StetelThings/iotex-devboard/schematic/IoTeX-Devboard.pdf

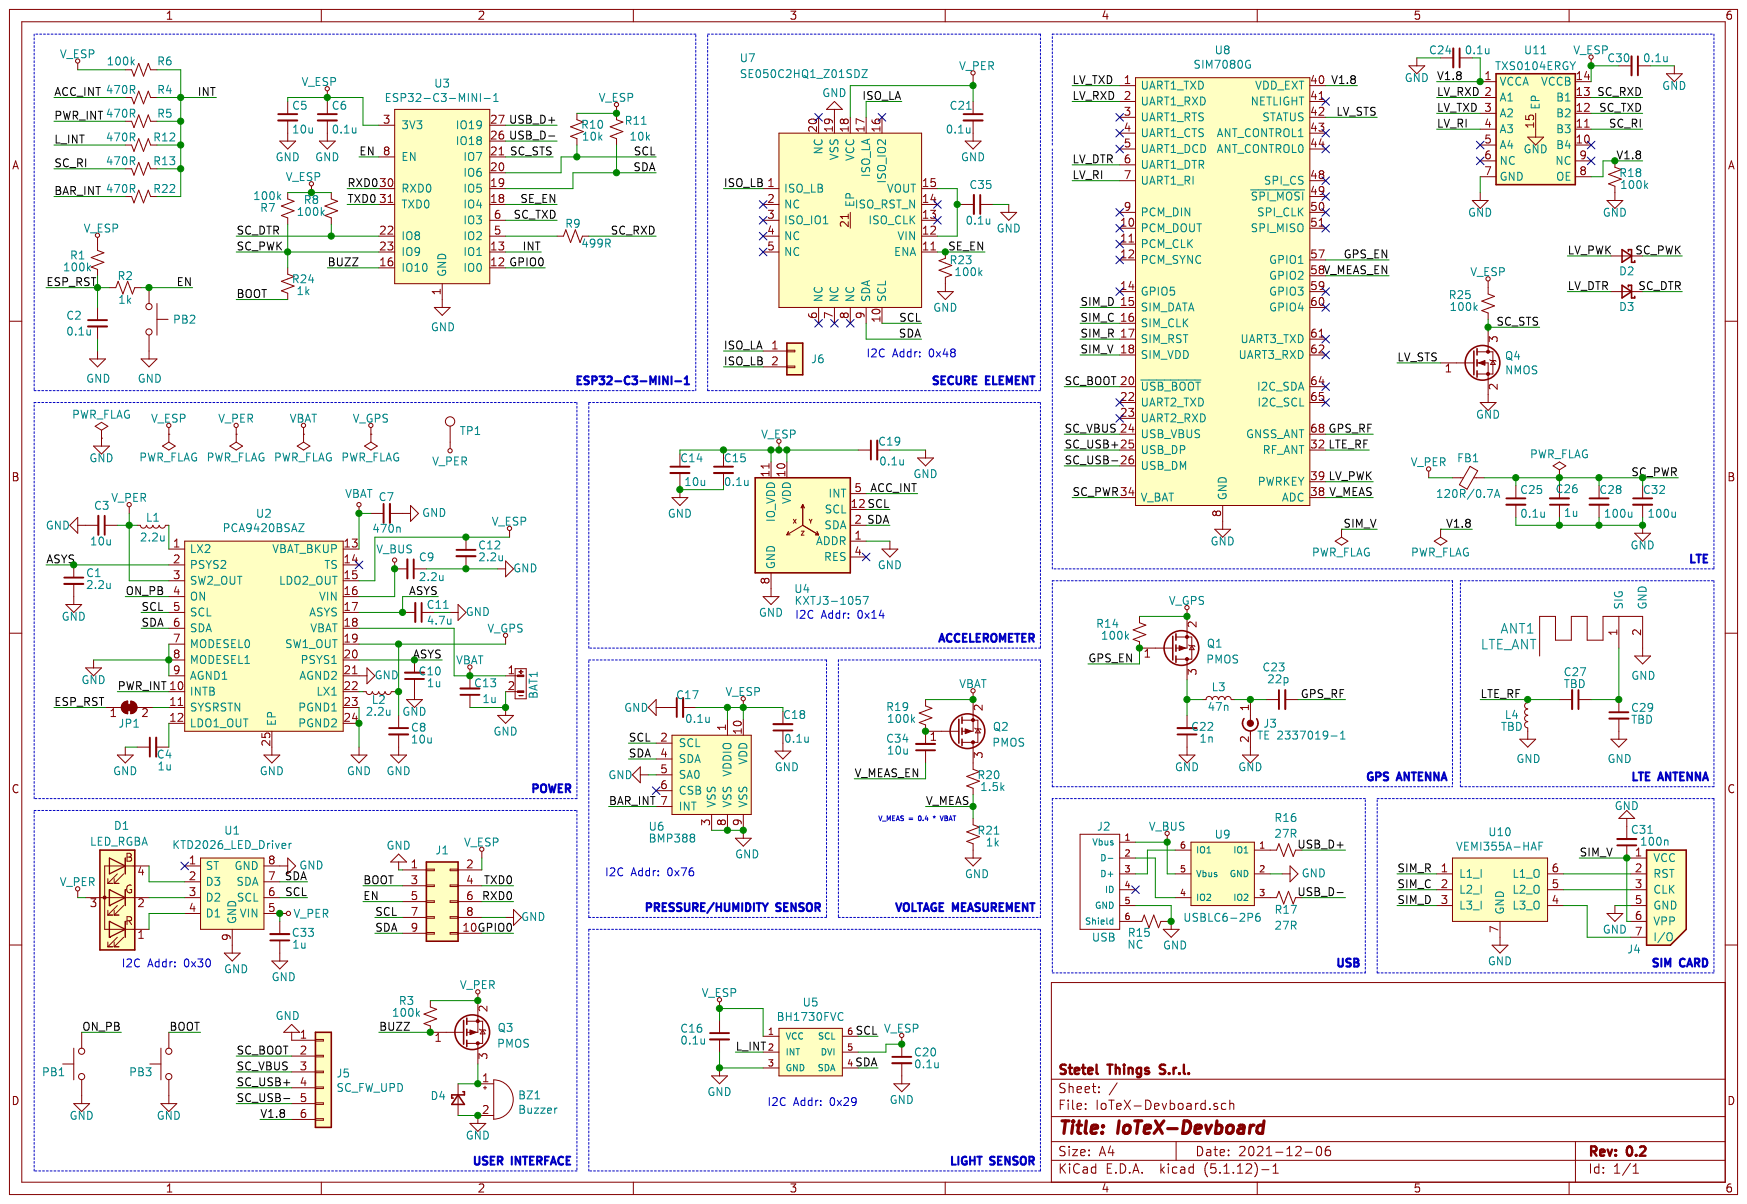
[picture p7: page 1]
