StetelThings/iotex-devboard/schematic/KiCad/IoTeX-Devboard.sch

## KiCad design schematic/KiCad/IoTeX-Devboard.sch (2022-07-04)

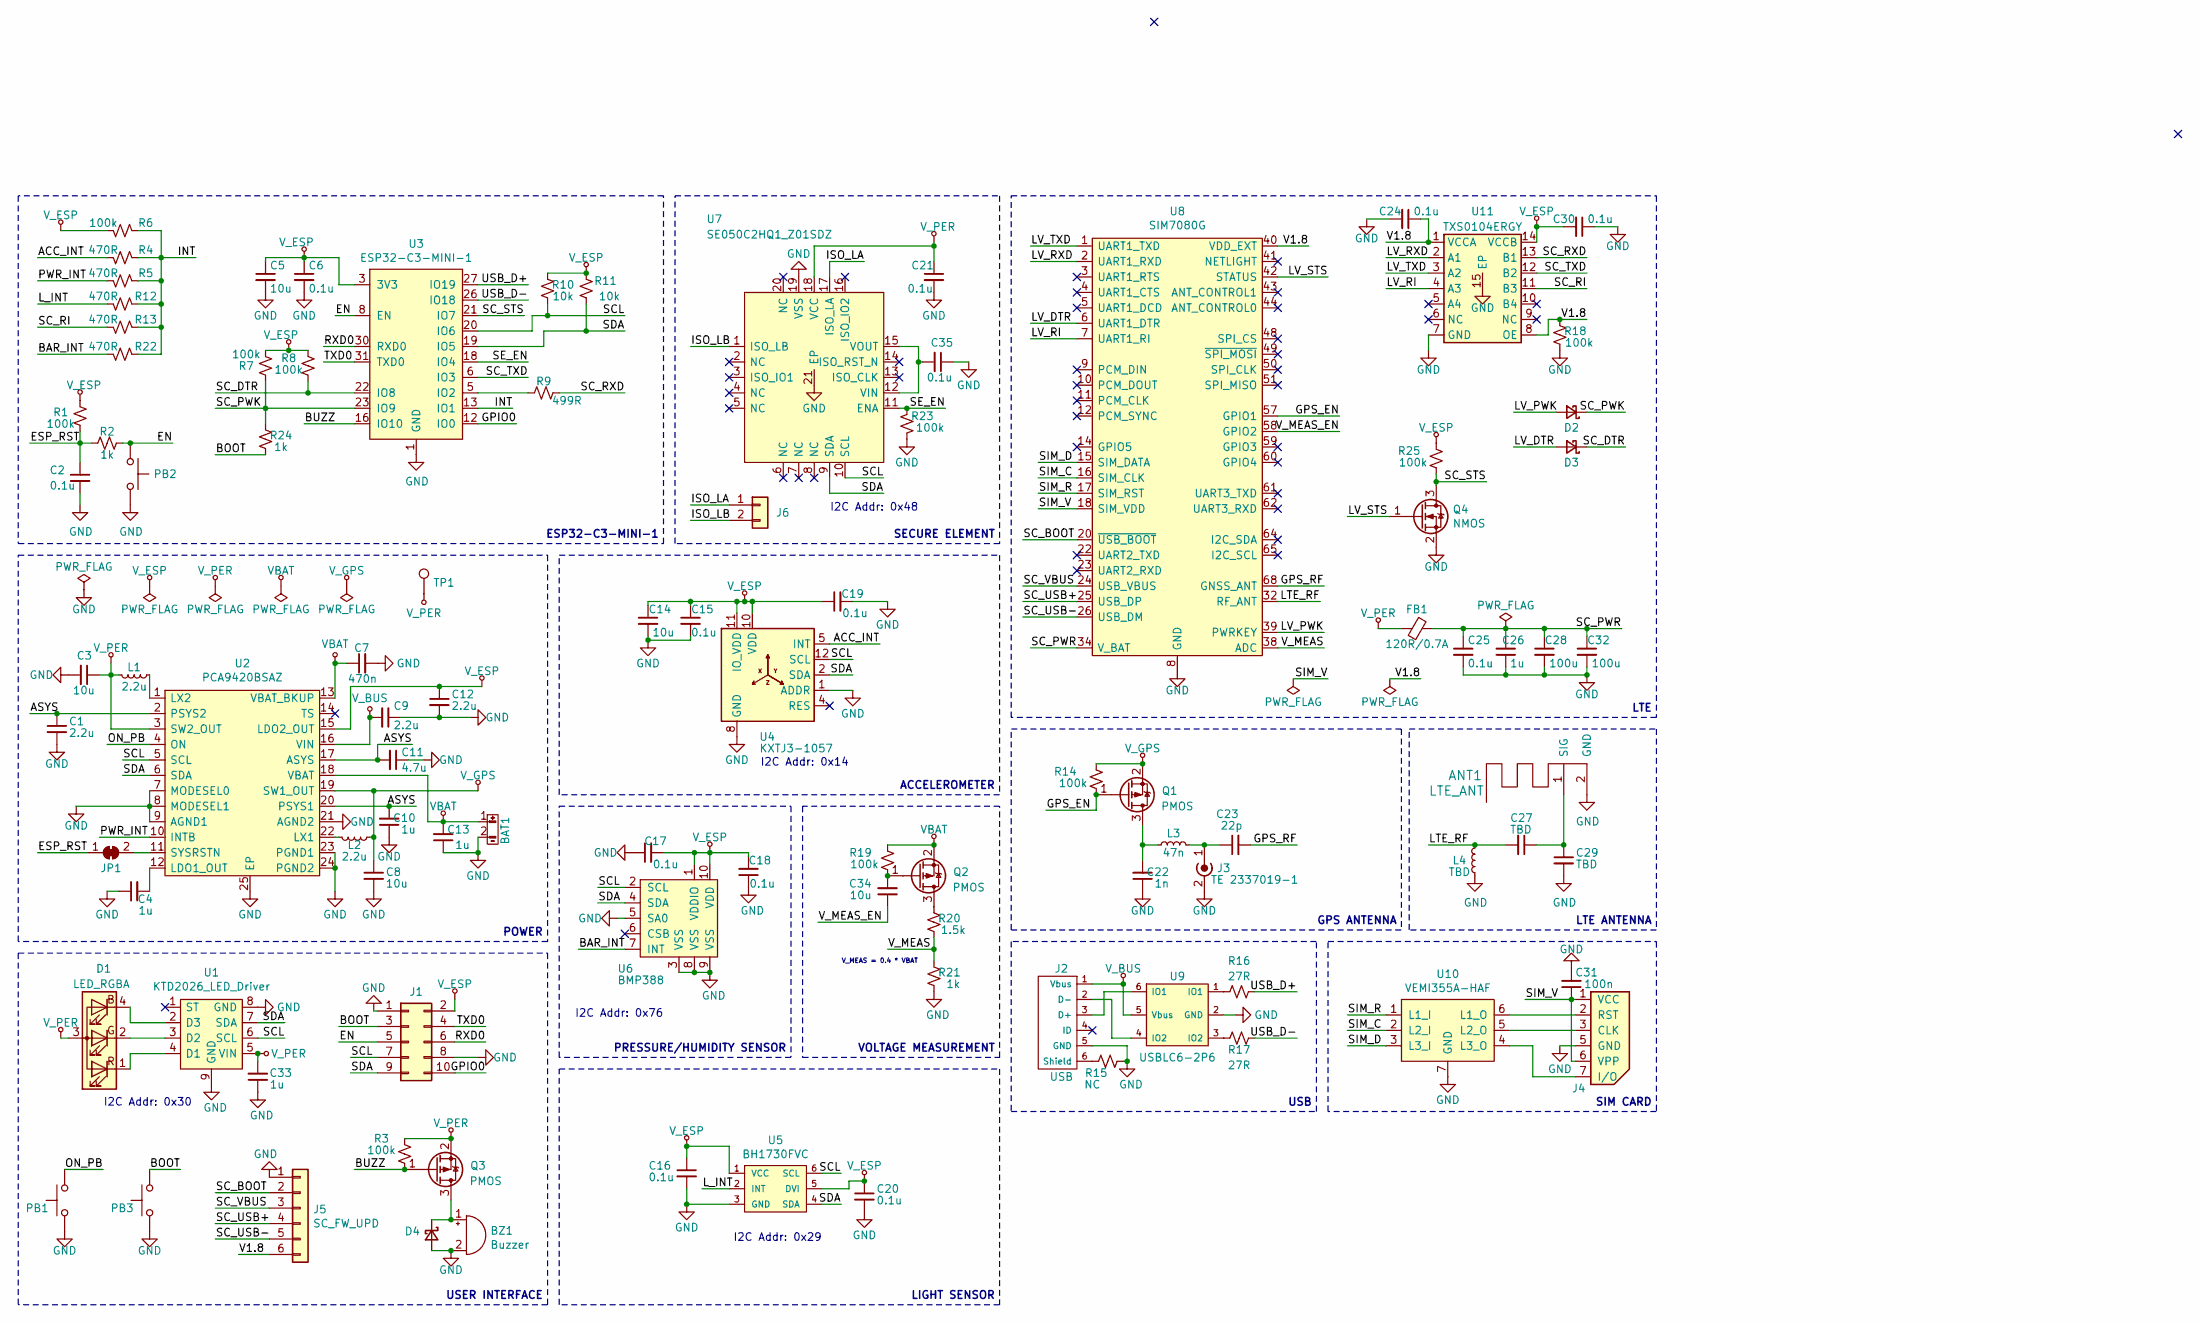
[picture p8: schematic IoTeX-Devboard.sch]

Parts:
ANT1: LTE_ANT; LTE-NB_ANTENNA
BAT1: Battery_Connector; Battery_PADS
BZ1: Buzzer; FUET-4020_BUZZER
C1, C9, C12: 2.2u; C_0402_1005Metric
C2, C6, C15, C16, C17, C18, C19, C20, C21, C24, C25, C30, C35: 0.1u; C_0402_1005Metric
C3, C5, C8, C14, C34: 10u; C_0402_1005Metric
C4, C10, C13, C26, C33: 1u; C_0402_1005Metric
C7: 470n; C_0402_1005Metric
C11: 4.7u; C_0402_1005Metric
C22: 1n; C_0402_1005Metric
C23: 22p; C_0402_1005Metric
C27, C29: TBD; C_0402_1005Metric
C28, C32: 100u; C_1206_3216Metric
C31: 100n; C_0402_1005Metric
D1: LED_RGBA; LED_RGB_IN-S85TATRGB
D2, D3, D4: D_Schottky_Small; D_0603_1608Metric
FB1: 120R/0.7A; L_0603_1608Metric
J1: Conn_02x05_Odd_Even; Wurth_Debug_490107670612_connector_10pins
J2: USB; USB-microB_U254-051T-4BH83-F1S
J3: TE 2337019-1; U.FL_Hirose_U.FL-R-SMT-1_Vertical
J4: SIM_Card_small; XUNPU-SMN-305_C266890_nanoSIM_Holder
J5: SC_FW_UPD; PinHeader_1x06_P1.00mm_Vertical
J6: Conn_01x02; PinHeader_1x02_P1.27mm_Vertical
JP1: SolderJumper_2_Bridged; SolderJumper-2_P1.3mm_Bridged_RoundedPad1.0x1.5mm
L1, L2: 2.2u; L_0805_2012Metric
L3: 47n; L_0402_1005Metric
L4: TBD; L_0402_1005Metric
PB1, PB3: K2-1107UT-A45W-06; SW_SPST_PTS815
PB2: KXT331LHS; SW_SPST_CK_KXT3
Q1, Q2, Q3: PMOS; DFN1006-3
Q4: NMOS
R1, R3, R6, R7, R8, R14, R18, R19, R23, R25: 100k; R_0402_1005Metric
R2, R21, R24: 1k; R_0402_1005Metric
R4, R5, R12, R13, R22: 470R; R_0402_1005Metric
R9: 499R; R_0402_1005Metric
R10, R11: 10k; R_0402_1005Metric
R15: NC; R_0402_1005Metric
R16, R17: 27R; R_0402_1005Metric
R20: 1.5k; R_0402_1005Metric
TP1: TestPoint; TestPoint_Pad_D1.0mm
U1: KTD2026_LED_Driver; SON40P150X150X60-9N-D; Manufacturer_Part_Number KTD2026
U2: PCA9420BSAZ; Manufacturer_Part_Number PCA9420BSAZ; Mouser Part Number 771-PCA9420BSAZ
U3: ESP32-C3-MINI-1
U4: KXTJ3-1057; Kionix_LGA-12_2x2mm_P0.5mm_LayoutBorder2x4y
U5: BH1730FVC; ROHM_BH1730FVC-TR
U6: BMP388
U7: SE050C2HQ1_Z01SDZ; QFN-20-1EP_3x3mm_P0.4mm_EP1.65x1.65mm; Manufacturer_Part_Number SE050C2HQ1/Z01SDZ; Mouser Part Number 771-SE050C2HQ1Z01SDZ
U8: SIM7080G; Manufacturer_Part_Number SIM7080G
U9: USBLC6-2P6
U10: VEMI355A-HAF
U11: TXS0104ERGY; RGY_S-PVQFN-N14_

Connections:
ACC_INT: R4.1, U4.5 (INT)
ASYS: C1.1, C10.2, C11.2, U2.2 (PSYS2), U2.17 (ASYS), U2.20 (PSYS1)
BAR_INT: R22.1, U6.7 (INT)
BOOT: J1.3, PB3.1, R24.1
BUZZ: Q3.1 (G), R3.2, U3.16 (IO10)
EN: J1.5, PB2.1, R2.1, U3.8 (EN)
ESP_RST: C2.1, JP1.1 (A), R1.1, R2.2
GND: ANT1.2 (GND), BAT1.2, BZ1.2 (+), C1.2, C2.2, C3.2, C4.1, C5.2, C6.2, C7.2, C8.2, C9.1, C10.1, C11.1, C12.2, C13.1, C14.2, C15.2, C16.2, C17.1, C18.1, C19.2, C20.2, C21.2, C22.1, C24.2, C25.2, C26.1, C28.2, C29.2, C30.1, C31.2, C32.2, C33.1, C35.1, D4.2 (A), J1.1, J1.8, J2.5 (GND), J3.2 (Ext), J4.5 (GND), J5.1, L4.1, PB1.2, PB2.2, PB3.2, Q4.2 (S), R15.2, R18.2, R21.2, R23.2, U1.8 (GND), U1.9 (GND), U2.7 (MODESEL0), U2.8 (MODESEL1), U2.9 (AGND1), U2.21 (AGND2), U2.23 (PGND1), U2.24 (PGND2), U2.25 (EP), U3.1 (GND), U3.2 (GND), U3.11 (GND), U3.14 (GND), U3.36 (GND), U3.37 (GND), U3.38 (GND), U3.39 (GND), U3.40 (GND), U3.41 (GND), U3.42 (GND), U3.43 (GND), U3.44 (GND), U3.45 (GND), U3.46 (GND), U3.47 (GND), U3.48 (GND), U3.49 (GND), U3.50 (GND), U3.51 (GND), U3.52 (GND), U3.53 (GND), U4.1 (ADDR), U4.6 (GND), U4.8 (GND), U4.9 (GND), U5.3 (GND), U6.3 (VSS), U6.5 (SA0), U6.8 (VSS), U6.9 (VSS), U7.19 (VSS), U7.21 (EP), U8.8 (GND), U8.13 (GND), U8.19 (GND), U8.21 (GND), U8.27 (GND), U8.30 (GND), U8.31 (GND), U8.33 (GND), U8.36 (GND), U8.37 (GND), U8.45 (GND), U8.63 (GND), U8.66 (GND), U8.67 (GND), U8.69 (GND), U8.70 (GND), U8.71 (GND), U8.72 (GND), U8.73 (GND), U8.74 (GND), U8.75 (GND), U8.76 (GND), U8.77 (GND), U9.2 (GND), U10.7 (GND), U11.7 (GND), U11.15 (EP)
GPIO0: J1.10, U3.12 (IO0)
GPS_EN: Q1.1 (G), R14.1, U8.57 (GPIO1)
GPS_RF: C23.2, U8.68 (GNSS_ANT)
INT: R4.2, R5.2, R6.1, R12.2, R13.2, R22.2, U3.13 (IO1)
ISO_LA: J6.1, U7.17 (ISO_LA)
ISO_LB: J6.2, U7.1 (ISO_LB)
LTE_RF: C27.2, L4.2, U8.32 (RF_ANT)
LV_DTR: D3.2 (A), U8.6 (UART1_DTR)
LV_PWK: D2.2 (A), U8.39 (PWRKEY)
LV_RI: U8.7 (UART1_RI), U11.4 (A3)
LV_RXD: U8.2 (UART1_RXD), U11.2 (A1)
LV_STS: Q4.1 (G), U8.42 (STATUS)
LV_TXD: U8.1 (UART1_TXD), U11.3 (A2)
L_INT: R12.1, U5.2 (INT)
unnamed: ANT1.1 (SIG), C27.1, C29.1
unnamed: BZ1.1 (-), D4.1 (K), Q3.3 (D)
unnamed: C4.2, U2.12 (LDO1_OUT)
unnamed: C22.2, L3.1, Q1.3 (D)
unnamed: C23.1, J3.1 (In), L3.2
unnamed: C34.2, Q2.1 (G), R19.1
unnamed: C35.2, U7.12 (VIN), U7.15 (VOUT)
unnamed: D1.1 (RK), U1.4 (D1)
unnamed: D1.2 (GK), U1.3 (D2)
unnamed: D1.4 (BK), U1.2 (D3)
unnamed: J2.2 (D-), U9.4 (IO2)
unnamed: J2.3 (D+), U9.6 (IO1)
unnamed: J2.6 (Shield), R15.1
unnamed: J4.2 (RST), U10.6 (L1_O)
unnamed: J4.3 (CLK), U10.5 (L2_O)
unnamed: J4.7 (I/O), U10.4 (L3_O)
unnamed: JP1.2 (B), U2.11 (SYSRSTN)
unnamed: L1.1, U2.1 (LX2)
unnamed: L2.2, U2.22 (LX1)
unnamed: Q2.3 (D), R20.1
unnamed: R9.1, U3.5 (IO2)
unnamed: R16.1, U9.1 (IO1)
unnamed: R17.2, U9.3 (IO2)
ON_PB: PB1.1, U2.4 (ON)
PWR_INT: R5.1, U2.10 (INTB)
RXD0: J1.6, U3.30 (RXD0)
SCL: J1.7, R10.1, U1.6 (SCL), U2.5 (SCL), U3.20 (IO6), U4.12 (SCL), U5.6 (SCL), U6.2 (SCL), U7.10 (SCL)
SC_BOOT: J5.2, U8.20 (~USB_BOOT)
SC_DTR: D3.1 (K), R8.1, U3.22 (IO8)
SC_PWK: D2.1 (K), R7.1, R24.2, U3.23 (IO9)
SC_PWR: C25.1, C26.2, C28.1, C32.1, FB1.1, U8.34 (V_BAT), U8.35 (V_BAT)
SC_RI: R13.1, U11.11 (B3)
SC_RXD: R9.2, U11.13 (B1)
SC_STS: Q4.3 (D), R25.1, U3.21 (IO7)
SC_TXD: U3.6 (IO3), U11.12 (B2)
SC_USB+: J5.4, U8.25 (USB_DP)
SC_USB-: J5.5, U8.26 (USB_DM)
SC_VBUS: J5.3, U8.24 (USB_VBUS)
SDA: J1.9, R11.1, U1.7 (SDA), U2.6 (SDA), U3.19 (IO5), U4.2 (SDA), U5.4 (SDA), U6.4 (SDA), U7.9 (SDA)
SE_EN: R23.1, U3.18 (IO4), U7.11 (ENA)
SIM_C: U8.16 (SIM_CLK), U10.2 (L2_I)
SIM_D: U8.15 (SIM_DATA), U10.3 (L3_I)
SIM_R: U8.17 (SIM_RST), U10.1 (L1_I)
SIM_V: C31.1, J4.1 (VCC), J4.6 (VPP), U8.18 (SIM_VDD)
TXD0: J1.4, U3.31 (TXD0)
USB_D+: R16.2, U3.27 (IO19)
USB_D-: R17.1, U3.26 (IO18)
V1.8: C24.1, J5.6, R18.1, U8.40 (VDD_EXT), U11.1 (VCCA), U11.8 (OE)
VBAT: BAT1.1 (+), C7.1, C13.2, Q2.2 (S), R19.2, U2.13 (VBAT_BKUP), U2.18 (VBAT)
V_BUS: C9.2, J2.1 (Vbus), U2.16 (VIN), U9.5 (Vbus)
V_ESP: C5.1, C6.1, C12.1, C14.1, C15.1, C16.1, C17.2, C18.2, C19.1, C20.1, C30.2, J1.2, R1.2, R6.2, R7.2, R8.2, R10.2, R11.2, R25.2, U2.15 (LDO2_OUT), U3.3 (3V3), U4.3 (IO_VDD), U4.7 (VDD), U4.10 (VDD), U4.11 (IO_VDD), U5.1 (VCC), U5.5 (DVI), U6.1 (VDDIO), U6.10 (VDD), U11.14 (VCCB)
V_GPS: C8.1, L2.1, Q1.2 (S), R14.2, U2.19 (SW1_OUT)
V_MEAS: R20.2, R21.1, U8.38 (ADC)
V_MEAS_EN: C34.1, U8.58 (GPIO2)
V_PER: C3.1, C21.1, C33.2, D1.3 (A), FB1.2, L1.2, Q3.2 (S), R3.1, TP1.1, U1.5 (VIN), U2.3 (SW2_OUT), U7.18 (VCC)

Notes on the sheet:
I2C Addr: 0x14
ESP32-C3-MINI-1
USB
LTE
SIM CARD
LTE ANTENNA
GPS ANTENNA
POWER
SECURE ELEMENT
I2C Addr: 0x76
I2C Addr: 0x29
USER INTERFACE
ACCELEROMETER
PRESSURE/HUMIDITY SENSOR
LIGHT SENSOR
VOLTAGE MEASUREMENT
V_MEAS = 0.4 * VBAT
I2C Addr: 0x30
I2C Addr: 0x48
