StetelThings/iotex-devboard/(commit log)

2021-12-06 FIrst publishing of the schematics, and PCB layout pictures
2021-12-07 Added KiCad schematics file
    [IoTeX-Devboard.sch]
2021-12-16 pcb from design completed to production
2022-01-28 added bare PCBs image and updated status
2022-02-01 Status update and real picture of board #0
2022-04-26 added board description
2022-07-04 IoTeX-Devboard v0.2 - Fixed STS line and Voltage Detector
    IoTeX-Devboard v0.2
    - Changed R21 value to 1k
    - Changed R20 value to 1.5k
    - Added Q4 and R25 level shifter
    - STS signal shifted with Q4 instead U11
    - Added C35 bypass capacitor
    [IoTeX-Devboard.sch]
